Catsarepro21/mouse/bom.md

| Quantity | Description | Link | Price (USD) |
|---:|---|---|---:|
| 2 | 1 uF 16 V X7R 0603 | [Link](https://www.digikey.com/en/products/detail/murata-electronics/GCM188R71C105KA64J/4903955) | $0.30 |
| 1 | 4.7 uF 16 V X7R 0805 | [Link](https://www.digikey.com/en/products/detail/tdk-corporation/C2012X7R1C475K125AB/2619200) | $0.30 |
| 9 | 100 nF 50 V X7R 0603 | [Link](https://www.digikey.com/en/products?keywords=GRM188R71H104KA93D) | $0.36 |
| 1 | 3.3 V addressable RGB LED 2020 package; pack of 20 | [Link](https://www.aliexpress.us/item/3256811941407150.html) | $4.95 |
| 1 | JST PH 2 mm two-pin right-angle SMT battery header | [Link](https://www.digikey.com/en/products/detail/jst-sales-america-inc/S2B-PH-SM4-TB/926655) | $0.49 |
| 1 | 220 ohm 1% 0603 | [Link](https://www.digikey.com/en/products?keywords=RC0603FR-07220RL) | $0.10 |
| 1 | 39 ohm 1% 0603 | [Link](https://www.digikey.com/en/products?keywords=RC0603FR-0739RL) | $0.10 |
| 2 | 4.7 kohm 1% 0603 | [Link](https://www.digikey.com/en/products?keywords=RC0603FR-074K7L) | $0.20 |
| 1 | 10 kohm 1% 0603 | [Link](https://www.digikey.com/en/products?keywords=RC0603FR-0710KL) | $0.10 |
| 1 | XIAO ESP32-C3 module with antenna | [Link](https://www.digikey.com/en/products/detail/seeed-technology-co-ltd/113991054/16652880) | $5.25 |
| 1 | Optical mouse sensor 16-pin DIP + LM19-LSI lens | [Link](https://www.aliexpress.us/item/2255800717950849.html) | $12.55 |
| 1 | 1.9 V 200 mA LDO SOT-23-THIN DDC | [Link](https://www.digikey.com/en/products/detail/texas-instruments/TLV70019DDCR/3202566) | $0.24 |
| 1 | 16-bit I2C GPIO expander SSOP-24 DB | [Link](https://www.digikey.com/en/products/detail/texas-instruments/TCA9555DBR/6161916) | $2.25 |
| 1 | Silent normally-open two-pin through-hole switch; pack of 5; Red variant; 7.3 mm red; pin spacing pending | [Link](https://www.aliexpress.us/item/3256805930044148.html) | $1.77 |
| 1 | Horizontal hollow-shaft scroll encoder, 9 mm, 24 detents, 12 pulses | [Link](https://www.digikey.com/en/products/detail/alps-alpine/EC10E1220501/21721562) | $1.04 |
| 1 | 1S 3.7 V 500 mAh 503035 LiPo; listing title specifies JST PH 2.0 mm; fit and charge rating pending | [Link](https://www.aliexpress.us/item/3256811727284188.html) | $7.35 |
| 5 | Custom mouse PCB; 2 layers, 1.6 mm, 51 x 84 mm | [Link](https://jlcpcb.com/) | $2.00 |
| 1 | M2 x 6 mm Phillips round-head self-tapping shell screws; pack of 100 | [Link](https://www.aliexpress.us/item/3256802119350443.html) | $1.36 |
| 1 | 70 x 100 mm PTFE sheet, nominal 0.6 mm; cut front and rear skates | [Link](https://www.aliexpress.us/item/3256805102398499.html) | $2.95 |
| 1 | Thin foam battery retention pad | — | $2.00 |
| 1 | M2 x 4 mm Phillips pan/round-head self-tapping screws; pack of 100 | [Link](https://www.aliexpress.us/item/3256802119350443.html) | $1.31 |
| 1 | Base; ASA preferred if available, otherwise opaque PETG (printed material) | [Link](https://github.com/Catsarepro21/mouse/blob/main/production/print/Base.stl) | $0.66 |
| 1 | Top cover; ASA preferred if available, otherwise opaque PETG (printed material) | [Link](https://github.com/Catsarepro21/mouse/blob/main/production/print/Top%20cover.stl) | $0.46 |
| 1 | Battery tray; PETG (printed material) | [Link](https://github.com/Catsarepro21/mouse/blob/main/production/print/Battery%20tray.stl) | $0.08 |
| 1 | Scroll wheel; PETG; translucent if wheel lighting is desired (printed material) | [Link](https://github.com/Catsarepro21/mouse/blob/main/production/print/Scroll%20wheel.stl) | $0.08 |
| 1 | Left RGB diffuser; Natural/translucent PETG (printed material) | [Link](https://github.com/Catsarepro21/mouse/blob/main/production/print/Left%20RGB%20diffuser.stl) | $0.01 |
| 1 | Right RGB diffuser; Natural/translucent PETG (printed material) | [Link](https://github.com/Catsarepro21/mouse/blob/main/production/print/Right%20RGB%20diffuser.stl) | $0.01 |
| 1 | AliExpress checkout additional charges | — | $2.34 |
| 1 | AliExpress checkout discount | — | -$0.31 |
| 1 | AliExpress shipping, current eligible order | — | $0.00 |
| 1 | DigiKey USPS shipping | [Link](https://www.digikey.com/en/help-support/delivery-information/delivery-time-and-cost) | $4.99 |
| 1 | JLCPCB shipping, quoted | [Link](https://jlcpcb.com/) | $3.12 |
