Catsarepro21/mouse/cad/Front skate.step

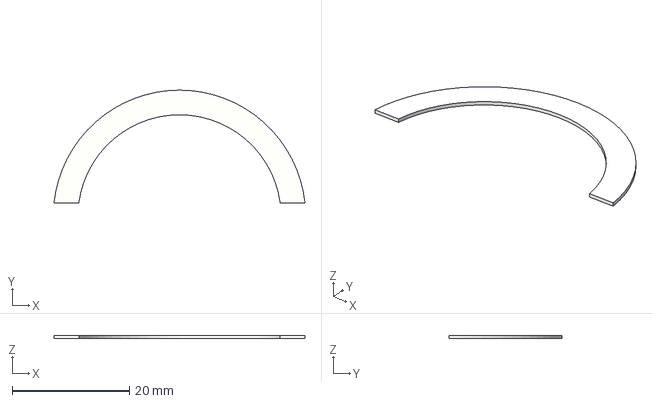
[picture p5: CAD file, 2026-11-07]
cad/Front skate.step
42.8 x 19.2 x 0.55 mm
