Catsarepro21/mouse/production/print/Scroll wheel.stl

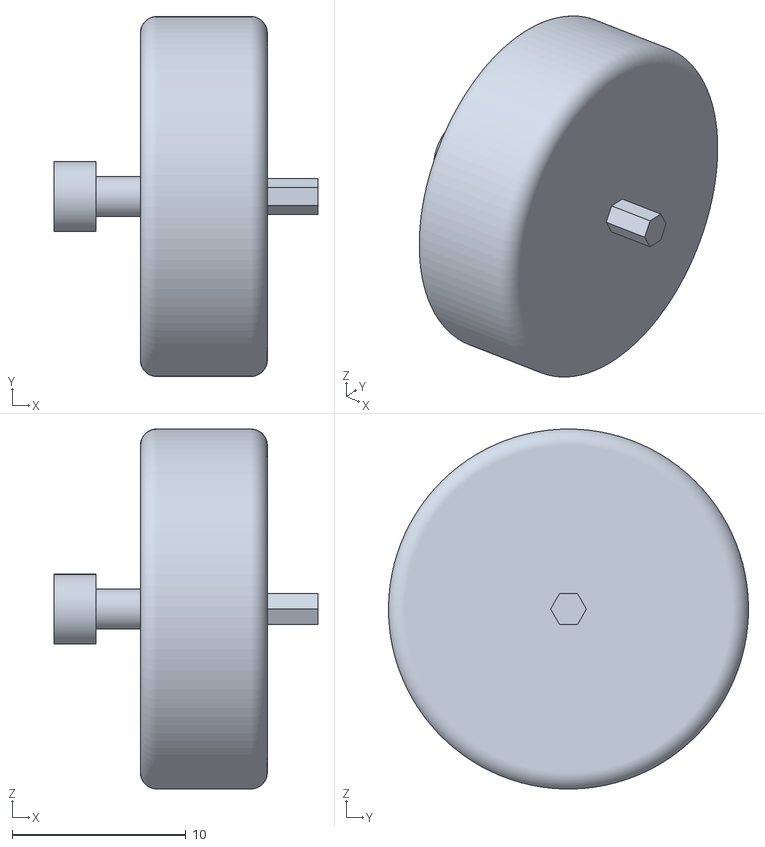
[picture p6: CAD file, 2026-11-07]
production/print/Scroll wheel.stl
15.2 x 20.7 x 20.7
