Catsarepro21/mouse/cad/mouse.step

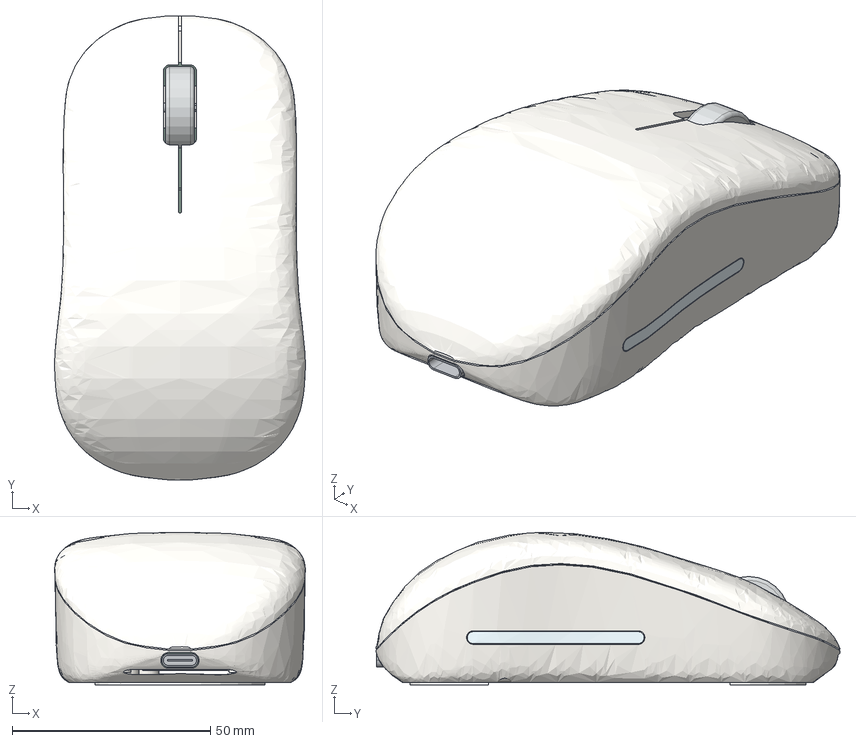
[picture p7: CAD file, 2026-11-07]
cad/mouse.step
63.4 x 117.1 x 38.5 mm
Top cover
Base
Scroll wheel
Battery tray
Rear USB-C receptacle envelope
Front skate
Rear skate
Left RGB diffuser
Right RGB diffuser
Revised populated PCB
Adafruit 1578 battery envelope
