Catsarepro21/mouse/production/print/Right RGB diffuser.stl

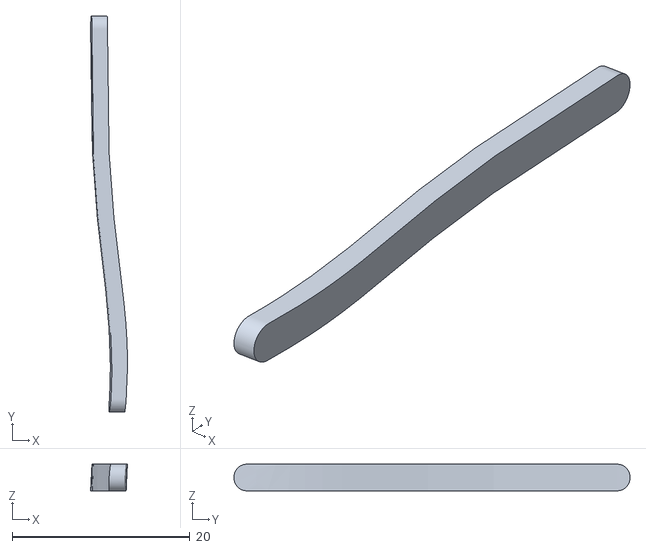
[picture p8: CAD file, 2026-11-07]
production/print/Right RGB diffuser.stl
4.15 x 44.6 x 3.00
