Catsarepro21/mouse/cad/Rear skate.step

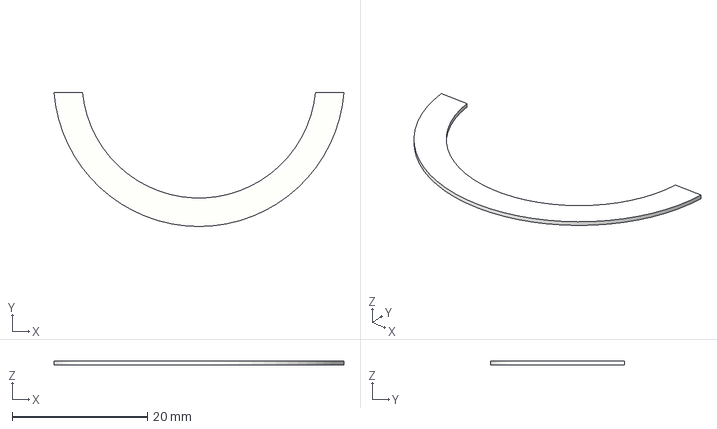
[picture p9: CAD file, 2026-11-07]
cad/Rear skate.step
42.9 x 19.8 x 0.55 mm
