Catsarepro21/mouse/production/print/Base.stl

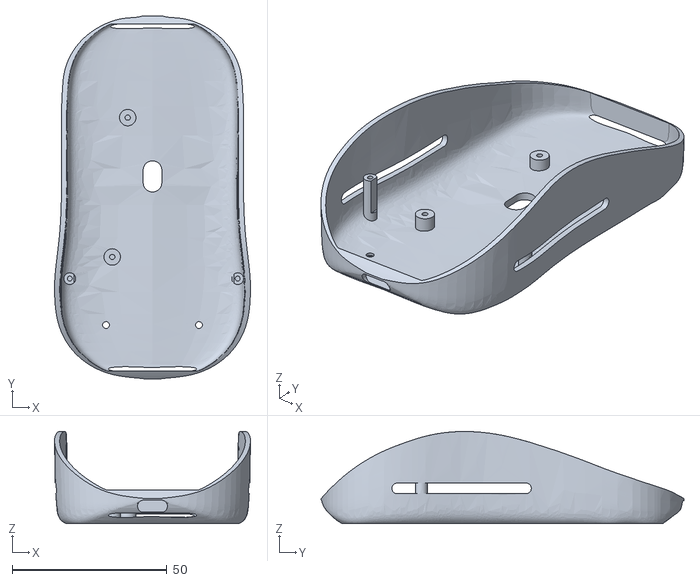
[picture p10: CAD file, 2026-11-07]
production/print/Base.stl
63.3 x 117.1 x 29.7
