Catsarepro21/mouse/production/print/Top cover.stl

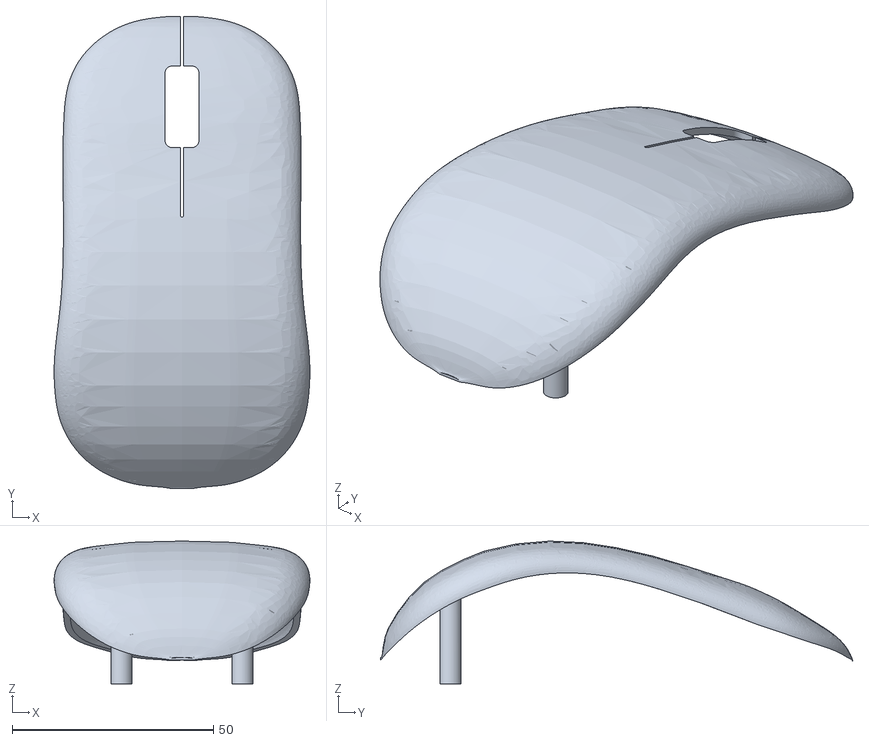
[picture p11: CAD file, 2026-11-07]
production/print/Top cover.stl
63.5 x 117.1 x 35.4
