Catsarepro21/mouse/production/print/Battery tray.stl

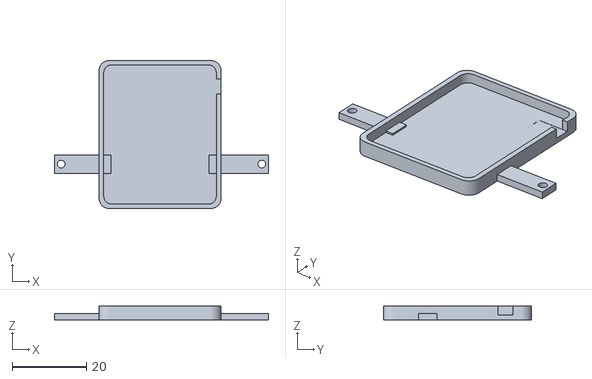
[picture p12: CAD file, 2026-11-07]
production/print/Battery tray.stl
57.8 x 40.0 x 3.70
