Catsarepro21/mouse/(list of files, cad)

Other CAD files:
production/print/Left RGB diffuser.stl
