Catsarepro21/mouse/PCB/Mouse.kicad_pcb

## KiCad design PCB/Mouse.kicad_pcb (2026-11-07)

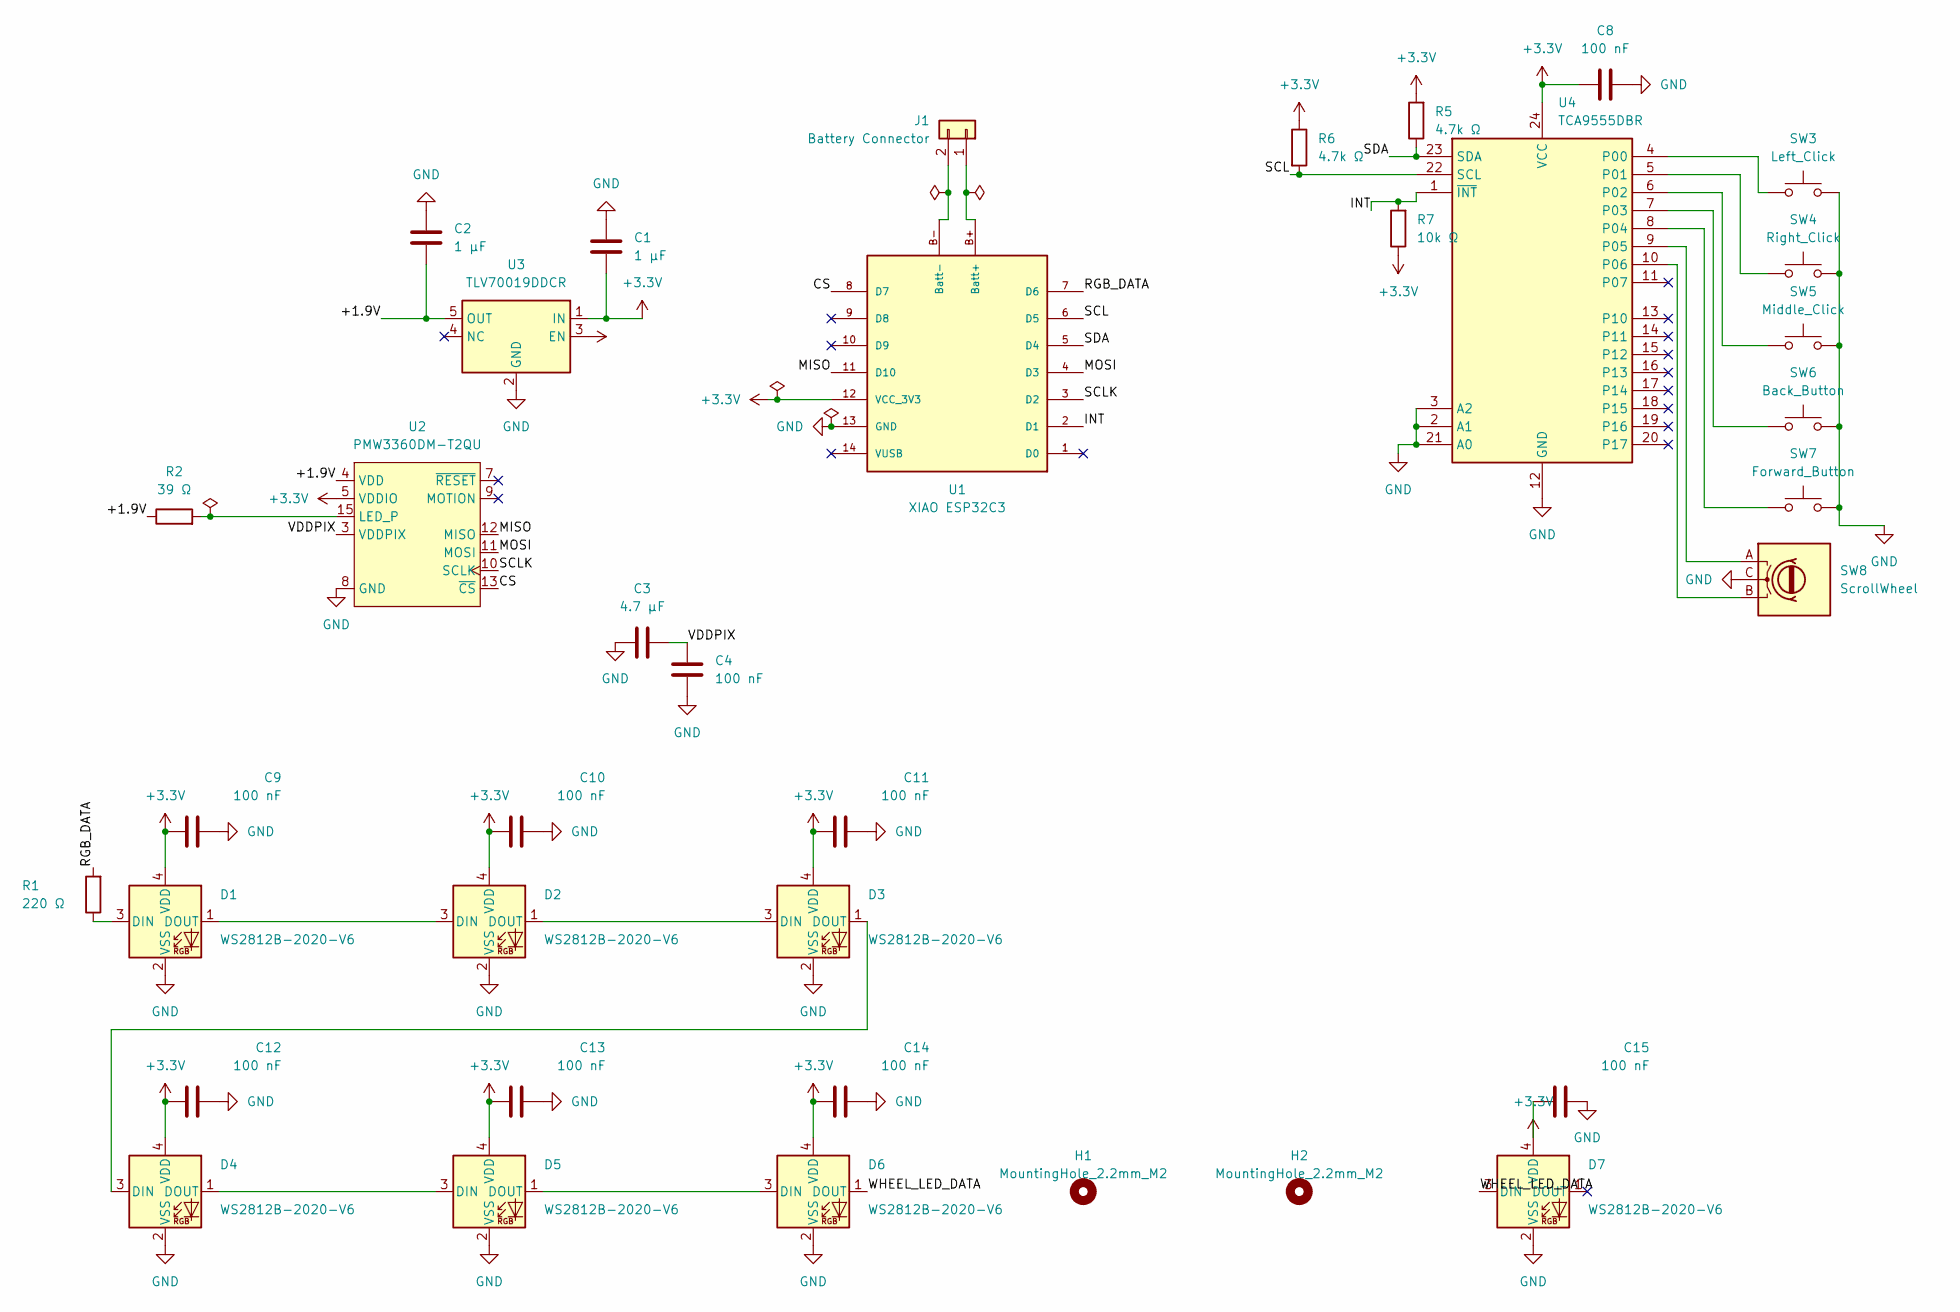
[picture p13: schematic Mouse.kicad_sch]

Parts:
C1, C2: 1 µF; C_0603_1608Metric_Pad1.08x0.95mm_HandSolder
C3: 4.7 µF; C_0805_2012Metric_Pad1.18x1.45mm_HandSolder
C4, C8, C9, C10, C11, C12, C13, C14, C15: 100 nF; C_0603_1608Metric_Pad1.08x0.95mm_HandSolder
D1, D2, D3, D4, D5, D6, D7: WS2812B-2020-V6; LED_WS2812B-2020_PLCC4_2.0x2.0mm
H1, H2: MountingHole_2.2mm_M2
J1: Battery Connector; JST_PH_S2B-PH-SM4-TB_1x02-1MP_P2.00mm_Horizontal
R1: 220 Ω; R_0603_1608Metric_Pad0.98x0.95mm_HandSolder
R2: 39 Ω; R_0603_1608Metric_Pad0.98x0.95mm_HandSolder
R5, R6: 4.7k Ω; R_0603_1608Metric_Pad0.98x0.95mm_HandSolder
R7: 10k Ω; R_0603_1608Metric_Pad0.98x0.95mm_HandSolder
SW3: Left_Click; Kailh_CMI627301D07
SW4: Right_Click; Kailh_CMI627301D07
SW5: Middle_Click; Kailh_CMI627301D07
SW6: Back_Button; SW_SPST_EVQP7A
SW7: Forward_Button; SW_SPST_EVQP7A
SW8: ScrollWheel; RotaryEncoder_Alps_EC10E1220501
U1: XIAO ESP32C3; xiao_esp32c3
U2: PMW3360DM-T2QU; PMW3360DM-T2QU 16Pin
U3: TLV70019DDCR; TI_DDC0005A
U4: TCA9555DBR; SSOP-24_5.3x8.2mm_P0.65mm

Connections:
+3.3V: C1.2, C8.1, C9.1, C10.1, C11.1, C12.1, C13.1, C14.1, C15.1, D1.4 (VDD), D2.4 (VDD), D3.4 (VDD), D4.4 (VDD), D5.4 (VDD), D6.4 (VDD), D7.4 (VDD), R5.2, R6.1, R7.1, U1.12 (VCC_3V3), U2.5 (VDDIO), U3.1 (IN), U3.3 (EN), U4.24 (VCC)
/+1.9V: C2.2, R2.1, U2.4 (VDD), U3.5 (OUT)
/CS: U1.8 (D7), U2.13 (~CS)
/INT: R7.2, U1.2 (D1), U4.1 (~INT)
/MISO: U1.11 (D10), U2.12 (MISO)
/MOSI: U1.4 (D3), U2.11 (MOSI)
/RGB_DATA: R1.2, U1.7 (D6)
/SCL: R6.2, U1.6 (D5), U4.22 (SCL)
/SCLK: U1.3 (D2), U2.10 (SCLK)
/SDA: R5.1, U1.5 (D4), U4.23 (SDA)
/VDDPIX: C3.1, C4.1, U2.3 (VDDPIX)
/WHEEL_LED_DATA: D6.1 (DOUT), D7.3 (DIN)
GND: C1.1, C2.1, C3.2, C4.2, C8.2, C9.2, C10.2, C11.2, C12.2, C13.2, C14.2, C15.2, D1.2 (VSS), D2.2 (VSS), D3.2 (VSS), D4.2 (VSS), D5.2 (VSS), D6.2 (VSS), D7.2 (VSS), SW3.2, SW4.2, SW5.2, SW6.2, SW7.2, SW8.C, U1.13 (GND), U2.8 (GND), U3.2 (GND), U4.2 (A1), U4.3 (A2), U4.12 (GND), U4.21 (A0)
unnamed: D1.3 (DIN), R1.1
unnamed: D1.1 (DOUT), D2.3 (DIN)
unnamed: D2.1 (DOUT), D3.3 (DIN)
unnamed: D3.1 (DOUT), D4.3 (DIN)
unnamed: D4.1 (DOUT), D5.3 (DIN)
unnamed: D5.1 (DOUT), D6.3 (DIN)
unnamed: J1.1, U1.B+ (Batt+)
unnamed: J1.2, U1.B- (Batt-)
unnamed: R2.2, U2.15 (LED_P)
unnamed: SW3.1, U4.4 (P00)
unnamed: SW4.1, U4.5 (P01)
unnamed: SW5.1, U4.6 (P02)
unnamed: SW6.1, U4.7 (P03)
unnamed: SW7.1, U4.8 (P04)
unnamed: SW8.A, U4.9 (P05)
unnamed: SW8.B, U4.10 (P06)

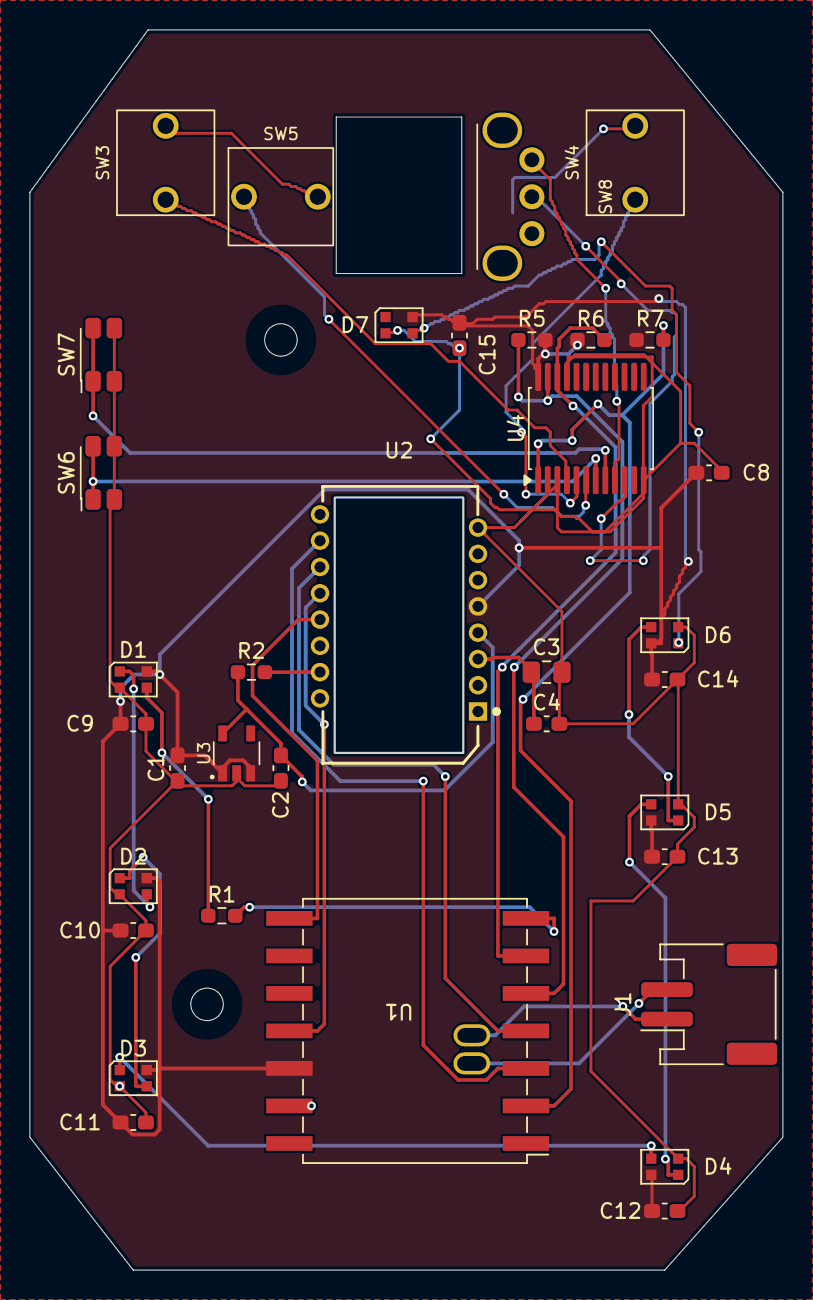
[picture p14: board Mouse.kicad_pcb from above]

Board: 2 copper layers, 51.0 x 84.0 mm, 37 parts (0 on the bottom side), 29 nets.
