Catsarepro21/mouse/code/PMW3360Srom.h

#pragma once
#include <stdint.h>

const uint8_t pmw3360Srom[] = {
  0x01, 0x03, 0x87, 0x8A, 0x56, 0x0F, 0xDE, 0x3E, 0xFE, 0x5F, 0x1D, 0xB8, 0xF2, 0x66, 0x4E, 0xFF,
  0x7C, 0x7A, 0x76, 0x4E, 0x1C, 0xB8, 0xD7, 0x0D, 0x79, 0x70, 0x62, 0x27, 0xCC, 0x1A, 0xB6, 0xEE,
  0x3F, 0xFC, 0x7A, 0x76, 0x4F, 0x1C, 0x9B, 0xB4, 0xCB, 0xF5, 0x49, 0x10, 0x83, 0x84, 0x8A, 0x96,
  0x8F, 0x7D, 0x78, 0x72, 0x66, 0x4D, 0x1E, 0xBE, 0xDF, 0x1D, 0x99, 0xB0, 0xE2, 0x46, 0x0E, 0x9E,
  0xBE, 0xFE, 0x7E, 0x7E, 0x7E, 0x7E, 0x5F, 0x1D, 0xBC, 0xF2, 0x47, 0x0C, 0x9A, 0xB6, 0xCF, 0x1C,
  0x9B, 0xB4, 0xCB, 0xF5, 0x49, 0x10, 0x83, 0x65, 0x48, 0x12, 0x87, 0x6D, 0x58, 0x32, 0xC7, 0x0C,
  0x9A, 0xB6, 0xCF, 0x1C, 0xBA, 0xF6, 0x6E, 0x5E, 0x1F, 0xBC, 0xDB, 0x34, 0xCB, 0x14, 0x8B, 0x94,
  0xAA, 0xB7, 0xCD, 0xF9, 0x70, 0x43, 0x04, 0xB7, 0x71, 0xBC, 0xBB, 0x4D, 0x30, 0x19, 0x01, 0x73,
  0x3F, 0xD7, 0xB9, 0x00, 0x10, 0x96, 0xCD, 0x16, 0xD5, 0x5F, 0xED, 0x63, 0x14, 0xF7, 0x61, 0x6A,
  0x4E, 0xB3, 0x8E, 0x70, 0x6E, 0x79, 0x9A, 0x51, 0x24, 0xB4, 0xC7, 0xCA, 0x58, 0x33, 0xEE, 0x94,
  0xC1, 0x2E, 0x50, 0x4C, 0xEC, 0x74, 0x6C, 0x4B, 0xE4, 0x5A, 0xF0, 0xBB, 0xB0, 0xBA, 0x38, 0x06,
  0xF7, 0x9B, 0xAC, 0xDE, 0x47, 0xC2, 0xF7, 0x3E, 0xA7, 0x4A, 0x33, 0x9D, 0x97, 0x3D, 0x89, 0x9D,
  0xF7, 0x28, 0x8A, 0xB2, 0x44, 0x44, 0x49, 0xAE, 0xE1, 0xF9, 0xEB, 0x36, 0xD2, 0x5D, 0x43, 0x85,
  0x55, 0x88, 0xE8, 0xA9, 0x81, 0xEA, 0xF7, 0x52, 0x7D, 0xD4, 0x88, 0x07, 0xDA, 0xD8, 0xCE, 0x3F,
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
  0xBA, 0x2D, 0xE4, 0x06, 0x31, 0x3D, 0x98, 0x72, 0x03, 0x42, 0xDF, 0x25, 0xC1, 0xA1, 0xF6, 0xAC,
  0xA9, 0x39, 0x85, 0x81, 0xF1, 0xA2, 0xD3, 0x03, 0xB1, 0xC8, 0x52, 0x89, 0x2F, 0x7A, 0xB3, 0x53,
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
};
static_assert(sizeof(pmw3360Srom) == 4094);
