Catsarepro21/mouse/(commit log)

2026-11-07 Inital Commit
    [Base.stl, Battery tray.stl, Front skate.step, Left RGB diffuser.stl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]
2026-11-07 Added Readme
    [Mouse-B_Cu.gbl, Mouse-B_Mask.gbs, Mouse-B_Silkscreen.gbo, Mouse-Edge_Cuts.gm1, Mouse-F_Cu.gtl, Mouse-F_Mask.gts, Mouse-F_Silkscreen.gto, Mouse-NPTH.drl]
2026-11-07 Added BOM
    [bom.csv]
2026-11-07 Simplified BOM
    [bom.csv]
2026-11-07 Cleaned BOM formatting
    [bom.csv]
